GlobalCSEd/roversa/readme.md

## Roversa Robot!

This repository is not being updated/maintained any longer. please use [Roversa 2](https://github.com/eb8ga/roversa2) for the latest version.

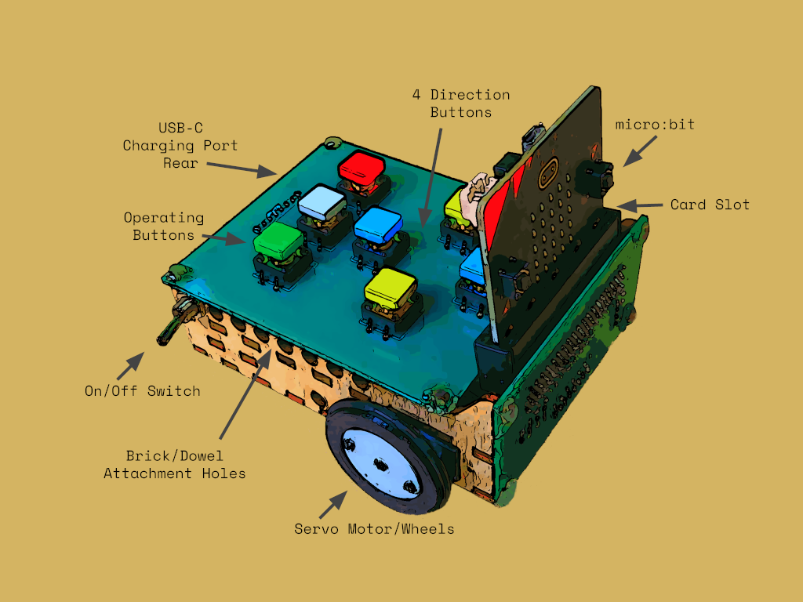
[picture p1: RAW_PICS/roversa v2.2-Getting Started GuideBCKGND.png]
roversa v2.1
