GlobalCSEd/roversa/CAD/PCB/readme.md

These are the two zip files containing gerber files for production. These can be dropped into a production site like OSHPark, JLC etc
