GlobalCSEd/roversa/RAW_PICS/IMG_20230713_214440.jpg

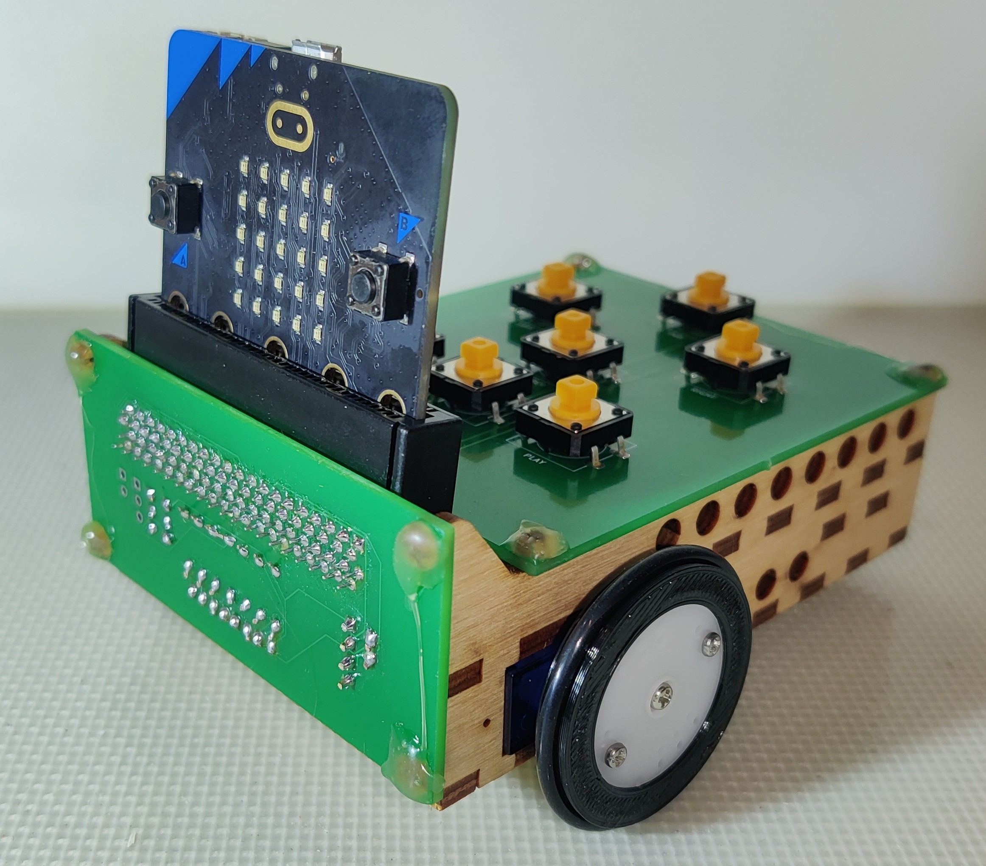
RAW_PICS/IMG_20230713_214440.jpg
