GlobalCSEd/roversa/RAW_PICS/IMG_20230713_214508.jpg

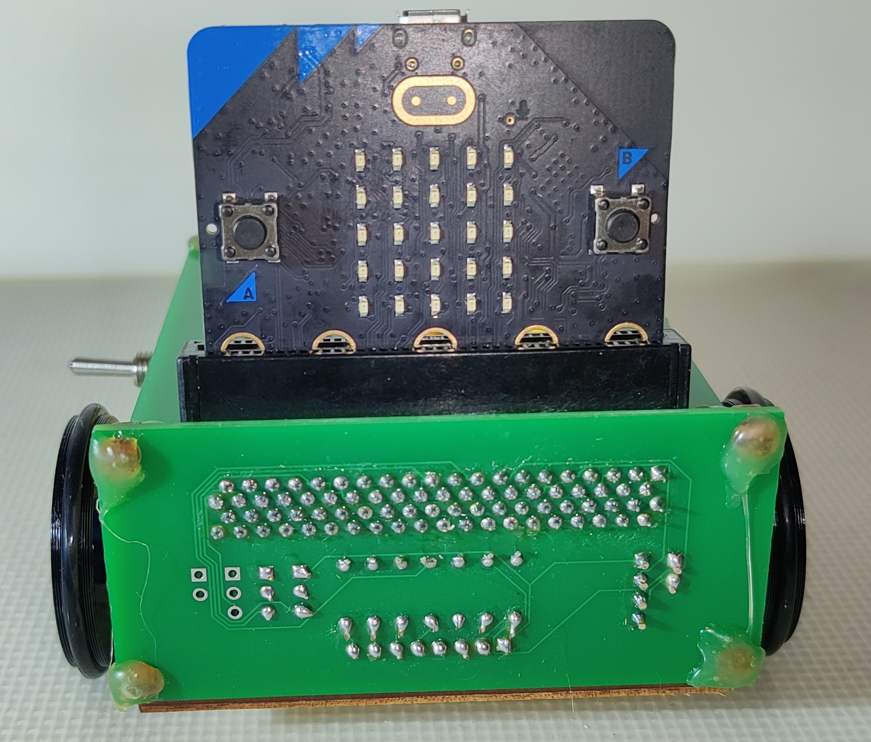
RAW_PICS/IMG_20230713_214508.jpg
