GlobalCSEd/roversa/RAW_PICS/IMG_20230713_214524.jpg

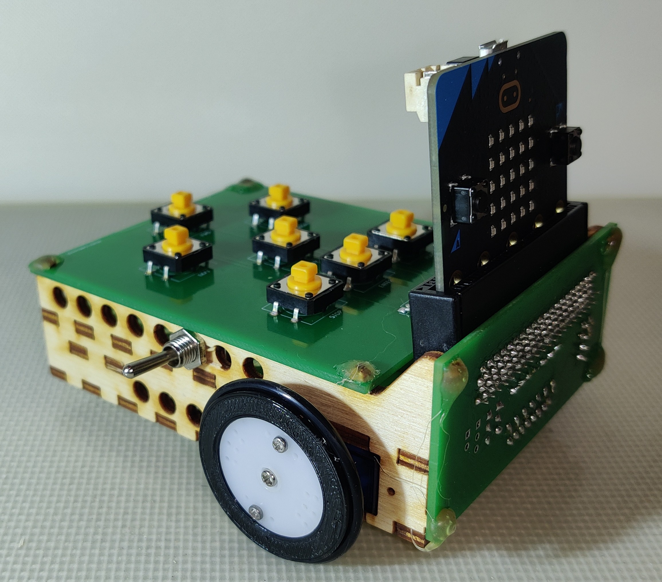
RAW_PICS/IMG_20230713_214524.jpg
