GlobalCSEd/roversa/RAW_PICS/IMG_20230713_214535.jpg

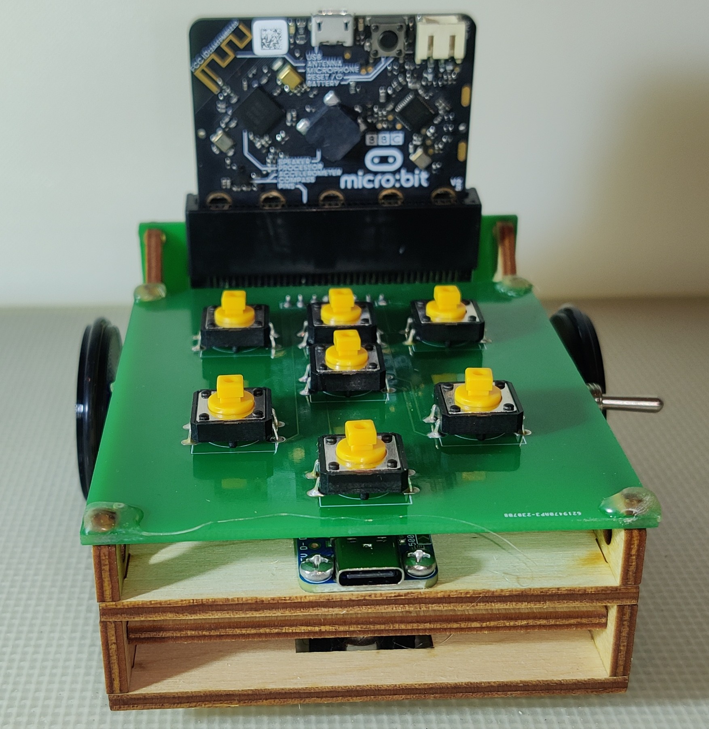
RAW_PICS/IMG_20230713_214535.jpg
