GlobalCSEd/roversa/RAW_PICS/IMG_20230713_214548.jpg

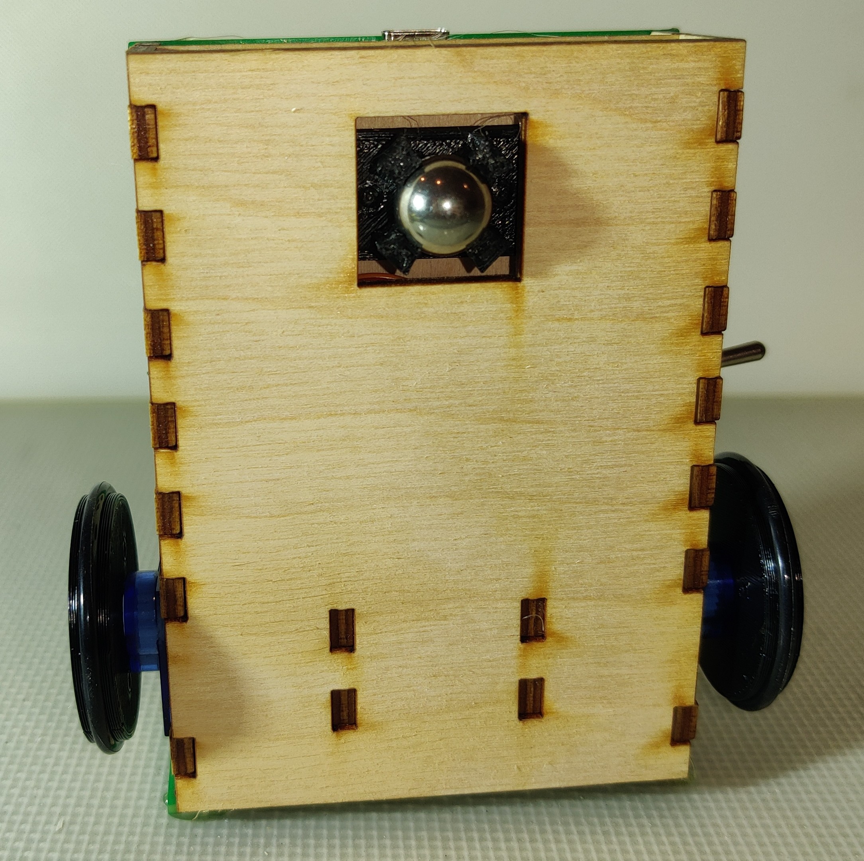
RAW_PICS/IMG_20230713_214548.jpg
