GlobalCSEd/roversa/RAW_PICS/IMG_20230713_214658.jpg

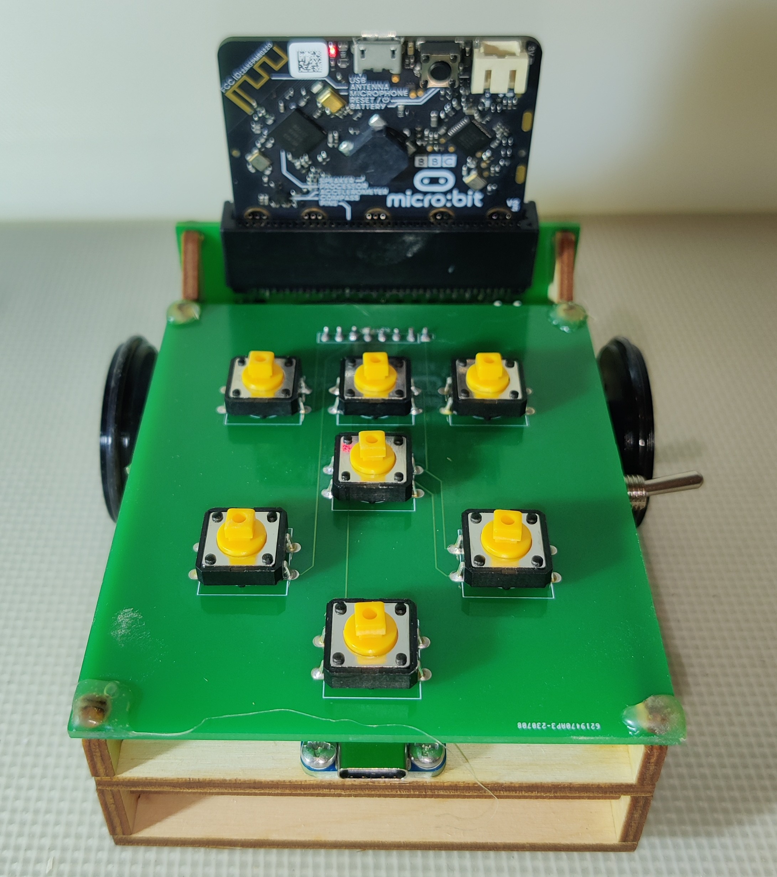
RAW_PICS/IMG_20230713_214658.jpg
