GlobalCSEd/roversa/RAW_PICS/IMG_20230713_214707.jpg

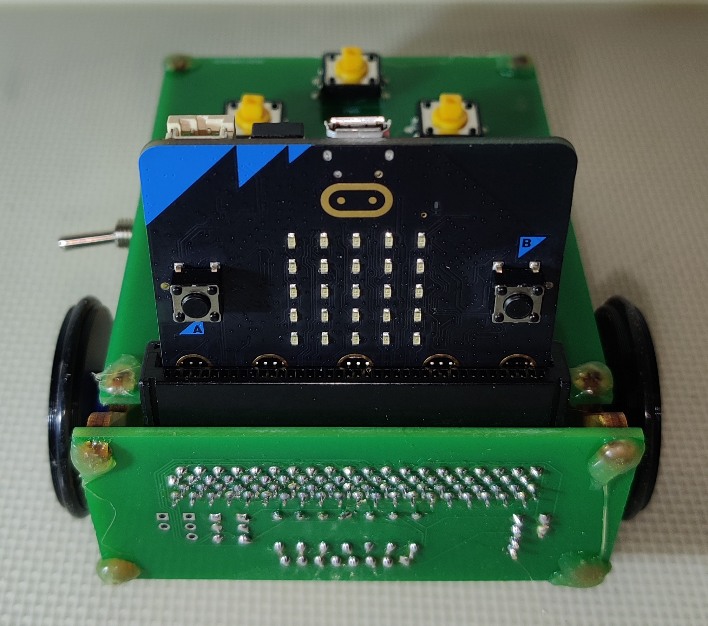
RAW_PICS/IMG_20230713_214707.jpg
