GlobalCSEd/roversa/RAW_PICS/IMG_20230713_214717.jpg

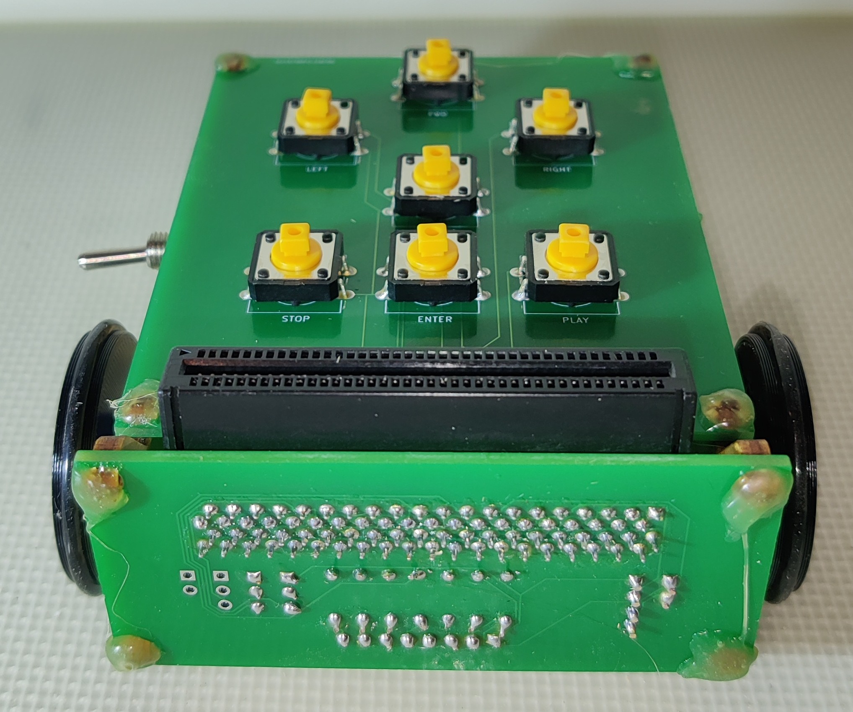
RAW_PICS/IMG_20230713_214717.jpg
