GlobalCSEd/roversa/RAW_PICS/IMG_20230713_214725.jpg

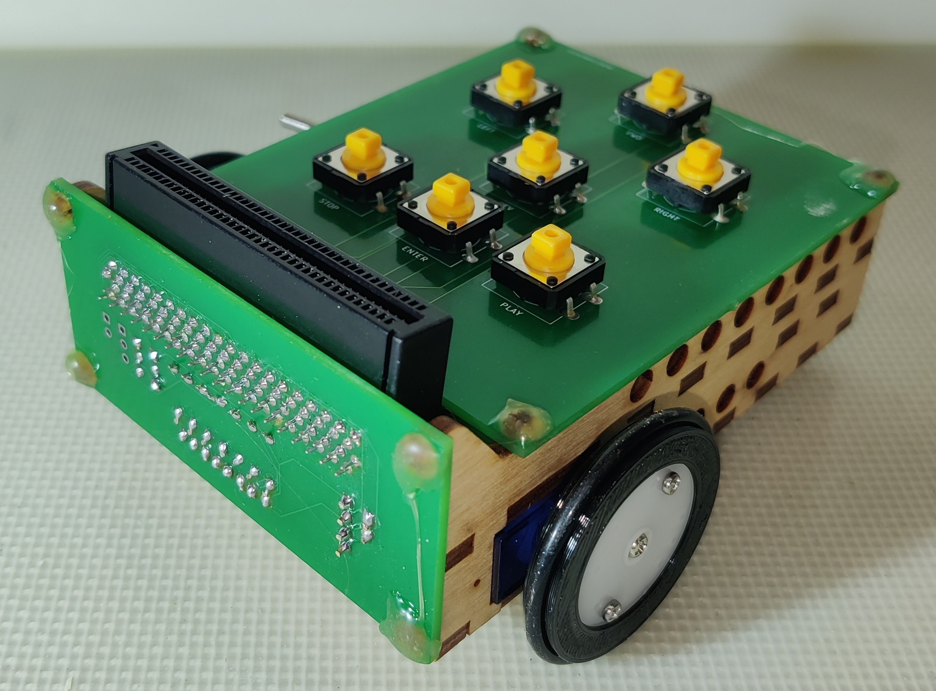
RAW_PICS/IMG_20230713_214725.jpg
