GlobalCSEd/roversa/RAW_PICS/IMG_20230713_214854.jpg

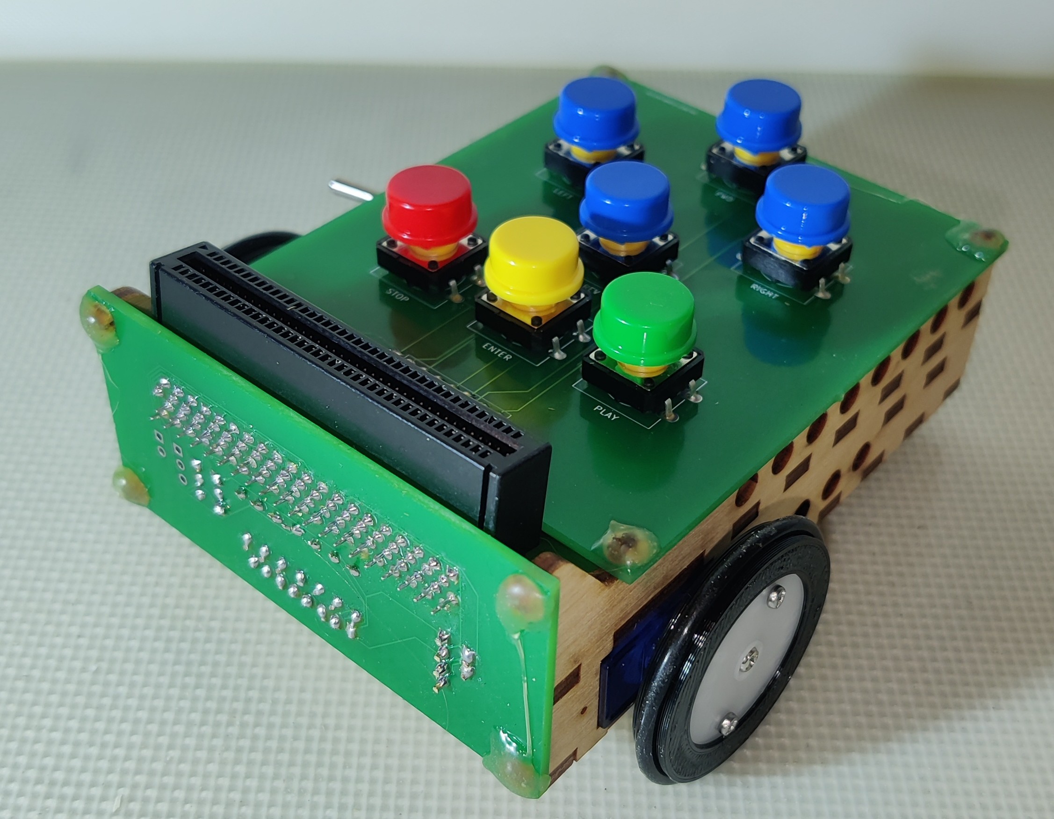
RAW_PICS/IMG_20230713_214854.jpg
