GlobalCSEd/roversa/RAW_PICS/IMG_20230713_214904.jpg

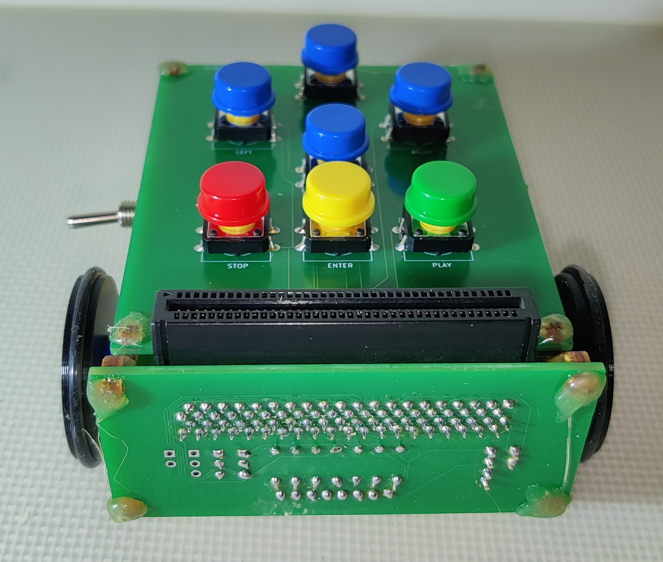
RAW_PICS/IMG_20230713_214904.jpg
