GlobalCSEd/roversa/RAW_PICS/IMG_20230713_214931.jpg

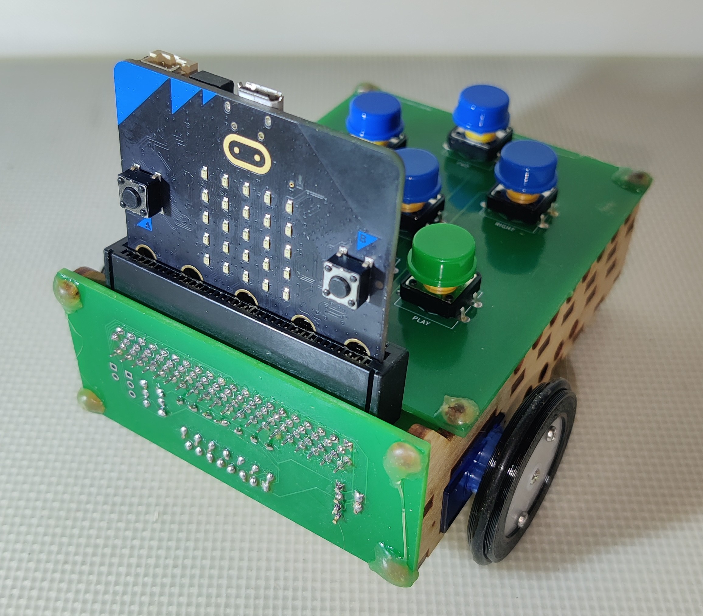
RAW_PICS/IMG_20230713_214931.jpg
