GlobalCSEd/roversa/RAW_PICS/IMG_20230713_214940.jpg

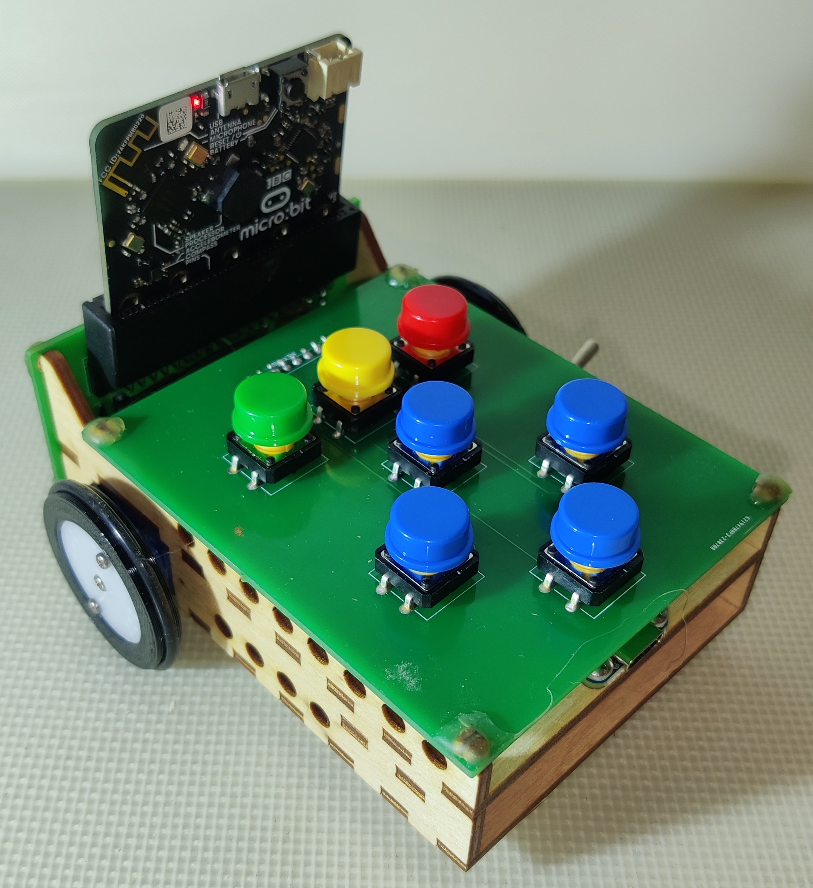
RAW_PICS/IMG_20230713_214940.jpg
