GlobalCSEd/roversa/RAW_PICS/IMG_20230713_215343.jpg

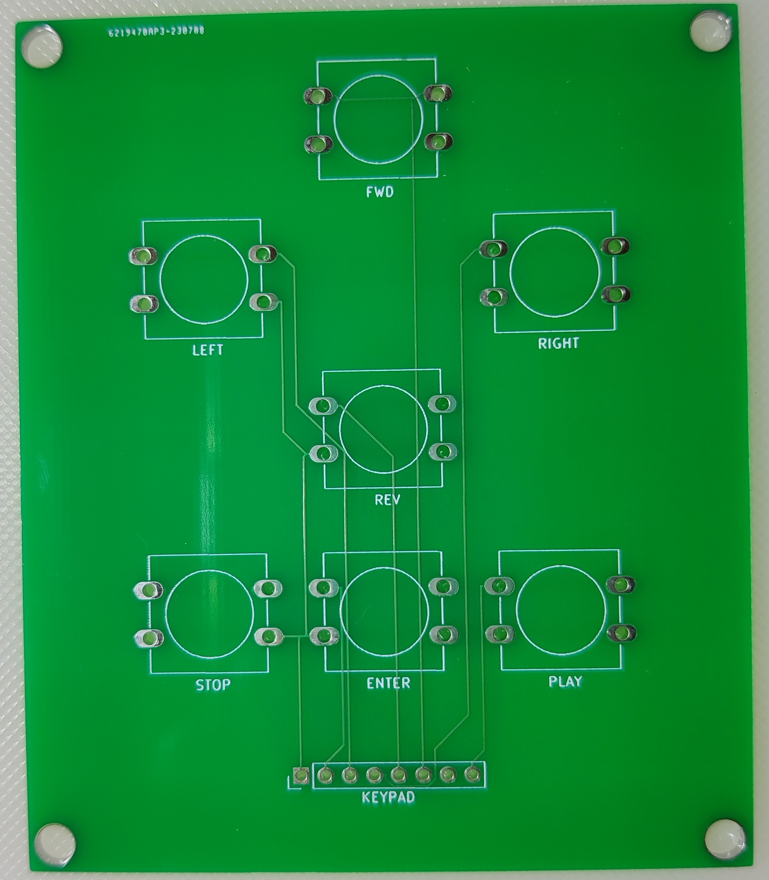
RAW_PICS/IMG_20230713_215343.jpg
