GlobalCSEd/roversa/RAW_PICS/IMG_20230713_215413.jpg

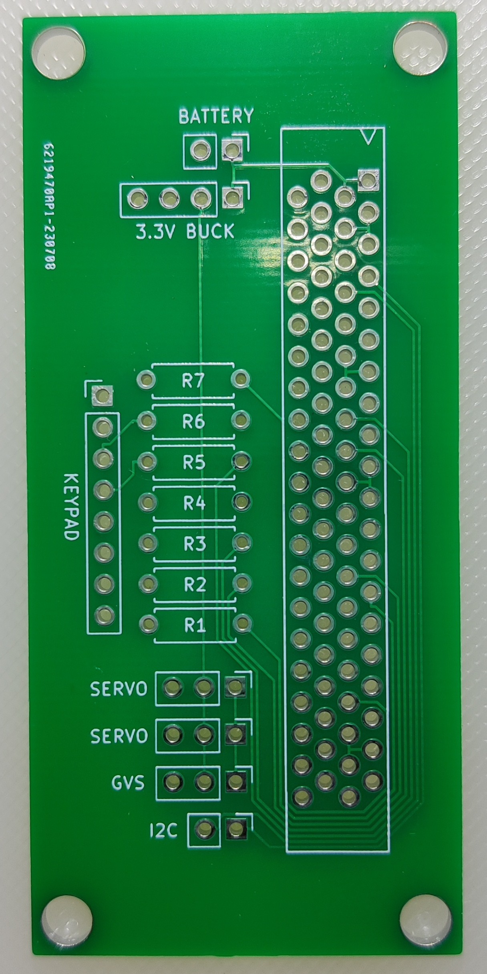
RAW_PICS/IMG_20230713_215413.jpg
