GlobalCSEd/roversa/RAW_PICS/IMG_20230808_182916__01.jpg

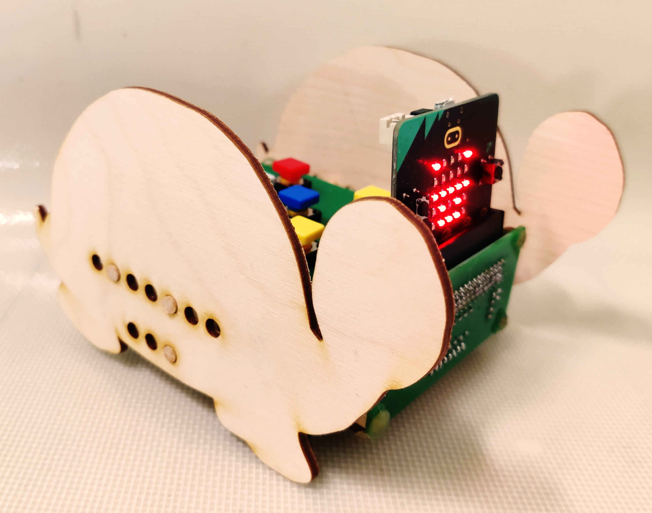
RAW_PICS/IMG_20230808_182916__01.jpg
