GlobalCSEd/roversa/BOM-mbRobotv2.2.xlsx

Sheet: START HERE
PLEASE READ BEFORE ORDERING PARTS
The sheet currentBuild has all the necessary parts to build Roversa. The sheet alternativeOptions has other sources and the parts we originally sourced to build v2.2 of the robot.
I will 3D print parts:
The Required parts list assumes you have capacity to 3D print the bearing holder and the wheels. If you have acces to a 3D printer, you can buy everything in the Required parts list and 3D print 1x Bearing Holder and 2x Wheels.
I will NOT 3D print parts:
If you do not have access to a 3D printer, you can buy everything on the Required parts list except the 12mm Ball Bearing, Nitrile Rubber O-Rings 35mm OD 30mm ID 2.5mm Width, and the M1.7x4mm Self-Tapping Screws. You will purchase 2x Wheel for Micro Continuous Rotation FS90R Servo, which comes with rubber tires. You can use the mounting screw from the servo horn kit provided. You will also purchase 1x 16mm Height Metal Caster Bearing Wheel, which comes with the steel ball bearing and holder. You may need to drill the mounting holes on this to fit the larger 2.5mm screws. They will then self-thread, so try to mount this once. Use a 2.05mm (5/64") drill bit for the pilot holes.
Production Notes
You will need to laser cut 1x chassis which is designed for 3mm playwood material (150 x 300 mm). They are sized to be able to fit 4x Roversa chassis layouts on one 300 x 600 mm sheet. All of the files are the same, we are just providing multiple formats to help work with different software.
You will need to manufacture 1x of each PCB zip files. They each contain all the gerber files necessary to create a full PCB to mount the micro:bit and also mount the button array.

Sheet: currentBuild
REQUIRED
Item | Component | Supplier Part No | Quantity | Cost (USD) | Total (USD) | Link | Notes | Datasheet
2x40 Right Angle Edge Connector for micro:bit | NA | 17252 | 1 | $2.95 | $2.95 | https://www.sparkfun.com/products/17252 | Use PTH version so it is easier to assemble | https://cdn-shop.adafruit.com/product-files/3342/Micro-Bit_connector_datasheet.pdf
Lithium Ion Polymer Battery - 3.7V 400mAh | NA | 13851 | 1 | $5.50 | $5.50 | https://www.sparkfun.com/products/13851 | Any LiPoly 3.7/4.2V Battery should work here - JST 2-Pin 25mm connector (check polarity) | https://cdn-shop.adafruit.com/product-files/3898/3898_specsheet_LP801735_400mAh_3.7V_20161129.pdf
Adafruit Micro-Lipo Charger for LiPoly Batt with USB Type C Jack | NA | 4410 | 1 | $5.95 | $5.95 | https://www.adafruit.com/product/4410 | Battery charge/maintenance, expensive can be integrated or cheaper version of LiPoly Charger | NA
2.2K ohm 5% 1/4W - Through-Hole Resistor | NA | 2782 | 7 | $0.03 | $0.21 | https://www.adafruit.com/product/2782 | Pull up resistors | https://adafruit.com/images/product-files/2780/Resistor_Data_Sheet.pdf
TLV62569 3.3V Buck Converter Breakout 3.3V Output 1.2A Max | NA | 4711 | 1 | $3.95 | $3.95 | https://www.adafruit.com/product/4711 | integrated circuit - fits to22 spot and has enable, not using currently | https://www.ti.com/lit/ds/symlink/tlv62569.pdf?ts=1696391638472
Continuous Rotation Micro Servo | FS90R | 114992423 | 2 | $2.90 | $5.80 | https://www.seeedstudio.com/Analog-Continuous-Steering-Servo-FS90R-p-4723.html | FSR90R - Variations may exist in mounting holes or size of part. CAD Matches the FITECH FS90R (https://www.adafruit.com/product/2442) | https://cdn-shop.adafruit.com/product-files/2442/FS90R-V2.0_specs.pdf
Colorful 12mm Square Tactile Button Switch | NA | NA | 7 | $0.13 | $0.91 | https://a.co/d/c8XVCTe | Any 12mm square tactile button will do, ones with caps are nice | https://cdn-shop.adafruit.com/datasheets/B3F-1000-Omron.pdf
Nitrile Rubber O-Rings 35mm OD 30mm ID 2.5mm Width | NA | NA | 2 | $0.22 | $0.44 | https://a.co/d/30GVs7j | O-rings for wheels - 3D printed wheel to attach to servo horn | NA
Latching Push Button Switch 3A 250V AC 2 Pins Self-Locking SPST ON/Off Black Mini Switch | NA | NA | 1 | $2.00 | $2.00 | https://a.co/d/6b5cvfP | Cleaner mounting option fits the v2.2 design | NA
M1.7x4mm Self-Tapping Screw | NA | NA | 4 | $0.01 | $0.04 | https://a.co/d/d1XQue5 | servo horn attachment - shorter so it doesn't polke through | NA
M2.5x6mm Pan Head Bolt/Screw | NA | NA | 6 | $0.09 | $0.54 | https://a.co/d/7hj75M6 | mount lipo charger and ball bearing holder if 3D printed | NA
12mm SS Ball Bearing | NA | NA | 1 | $0.50 | $0.50 | https://a.co/d/gPBLezj | Bearing is 12mm - 3D printed holder (if buying optional 16mm complete part- do not buy) | NA
 |  |  |  | TOTAL | $28.79 |  | Some of these are all really high prices and does not include microbit, wood, PCB
OPTIONAL
Item | Component | Supplier Part No | Quantity | Cost (USD) | Total (USD) | Link | Notes | Datasheet
16mm Height Metal Caster Bearing Wheel | NA | 3949 | 1 | $1.95 | $1.95 | https://www.adafruit.com/product/3949 | comes with ball bearing and holder (no need to 3D print anything, do not buy the 12mm ball bearing) | NA
Wheel for Micro Continuous Rotation FS90R Servo | NA | 2744 | 2 | $2.50 | $2.50 | https://www.adafruit.com/product/2744 | Different diameter than 3D printed wheels (no need to 3D print or use the M1.7x4mm screws) | https://www.adafruit.com/images/product-files/2744/2744%20data.pdf
microbit v2 | NA | 17287 | 1 | $16.50 | $16.50 | https://www.sparkfun.com/products/17287 | microbit v2 - assuming have this in base price | http://tech.microbit.org/
 |  |  |  | ADDITIONAL | $20.95 |  | extra items
 |  |  |  | TOTAL | $48.76 |  | base plus extra items, minus the servo horn screws, O-rings, and the ball bearing
PRODUCTION
Part | Material | Process | Files
Chassis | 3mm plywood | laser cut | SVG (https://github.com/GlobalCSEd/roversa/raw/main/CAD/mbRobotv2.2-8.8.23.svg) | PDF (https://github.com/GlobalCSEd/roversa/raw/main/CAD/mbRobotv2.2-8.8.23.pdf) | AI (https://github.com/GlobalCSEd/roversa/raw/main/CAD/mbRobotv2.2-8.8.23.ai)
Wheels | PETG | 3D printed | AMF (https://github.com/GlobalCSEd/roversa/raw/main/CAD/3DPrint/oRingServoWheel_30mmID.amf) | STL (https://github.com/GlobalCSEd/roversa/raw/main/CAD/3DPrint/oRingServoWheel_30mmID.stl)
Bearing Holder | PETG | 3D printed | AMF (https://github.com/GlobalCSEd/roversa/raw/main/CAD/3DPrint/bearingHolder-v2.2.amf) | STL (https://github.com/GlobalCSEd/roversa/raw/main/CAD/3DPrint/bearingHolder-v2.2.stl)
PCB - micro:bit | FR1 | PCB | ZIP (Gerbers) (https://github.com/GlobalCSEd/roversa/raw/main/CAD/PCB/gerbers-PCB-front_uBit.zip)
PCB - buttons | FR1 | PCB | ZIP (Gerbers) (https://github.com/GlobalCSEd/roversa/raw/main/CAD/PCB/gerbers-PCB-top_buttons.zip)

Sheet: alternativeOptions
Optional sources for cheaper options: | Supplier # | Cost/unit | Link
micro:bit edge connector | 17252 | $2.95 | https://www.sparkfun.com/products/17252
FS90R Servo Continuous Servo Motor |  | $5.95 | https://www.pololu.com/product/2820
FS90R Servo Continuous Servo Motor |  | $2.90 | https://www.seeedstudio.com/Analog-Continuous-Steering-Servo-FS90R-p-4723.html
400mah Lipo batteries |  | $4.00 | https://a.co/d/1dGfb0P
MPU6050 Gyro |  | $3.33 | https://a.co/d/0D5Rwem
12mm tactile buttons |  | $0.13 | https://a.co/d/c8XVCTe
SPST Momentary Latching |  | $2.00 | https://a.co/d/6b5cvfP
Lithium Ion Polymer Battery - 3.7V 400mAh | 13851 | $5.50 | https://www.sparkfun.com/products/13851
Original Parts (CAD-model): | Supplier # | Cost/unit | Link
FS90R Continuous Servo Motor | 2442 | $7.50 | https://www.adafruit.com/product/2442
micro:bit edge connector | 3342 | $5.95 | https://www.adafruit.com/product/3342
12mm tactile buttons | 1010 | $0.40 | https://www.adafruit.com/product/1010
SPST Momentary Latching |  | $3.25 | https://a.co/d/gLQk6vy
Lithium Ion Polymer Battery - 3.7V 400mAh | 3898 | $6.95 | https://www.adafruit.com/product/3898
