GlobalCSEd/roversa/CAD/3DPrint/CAD-v2.1/bearingHolder-v2.1.stl

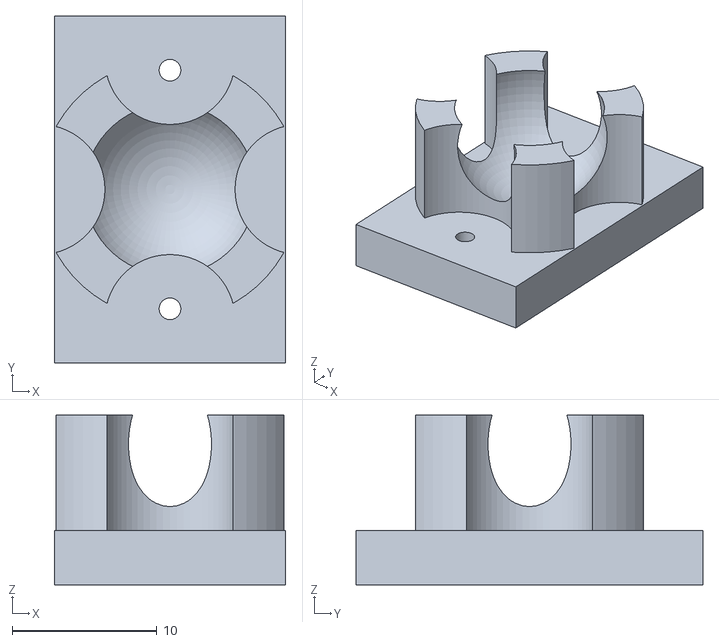
[picture p19: CAD file, 2023-09-07]
CAD/3DPrint/CAD-v2.1/bearingHolder-v2.1.stl
16.0 x 24.0 x 11.8
