GlobalCSEd/roversa/CAD/3DPrint/oRingServoWheel_30mmID.stl

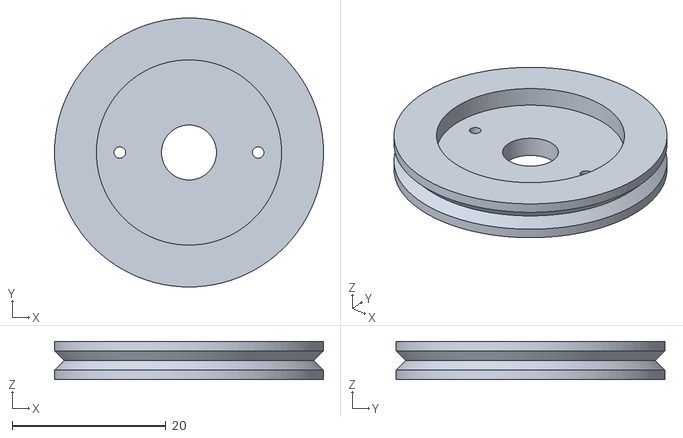
[picture p20: CAD file, 2023-09-07]
CAD/3DPrint/oRingServoWheel_30mmID.stl
35.0 x 35.0 x 5.00
