GlobalCSEd/roversa/(list of files, cad)

Other CAD files:
CAD/3DPrint/bearingHolder-v2.2.stl
CAD/3DPrint/CAD-v2.1/bearingHolder-v2.1.amf
CAD/3DPrint/bearingHolder-v2.2.amf
CAD/3DPrint/oRingServoWheel_30mmID.amf
