GlobalCSEd/roversa/ASSEMBLY/cadExploded.gif

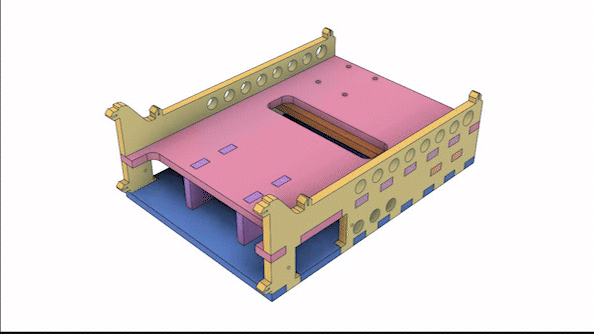
ASSEMBLY/cadExploded.gif
