GlobalCSEd/roversa/CAD/PCB/schematic_rev2.1.pdf

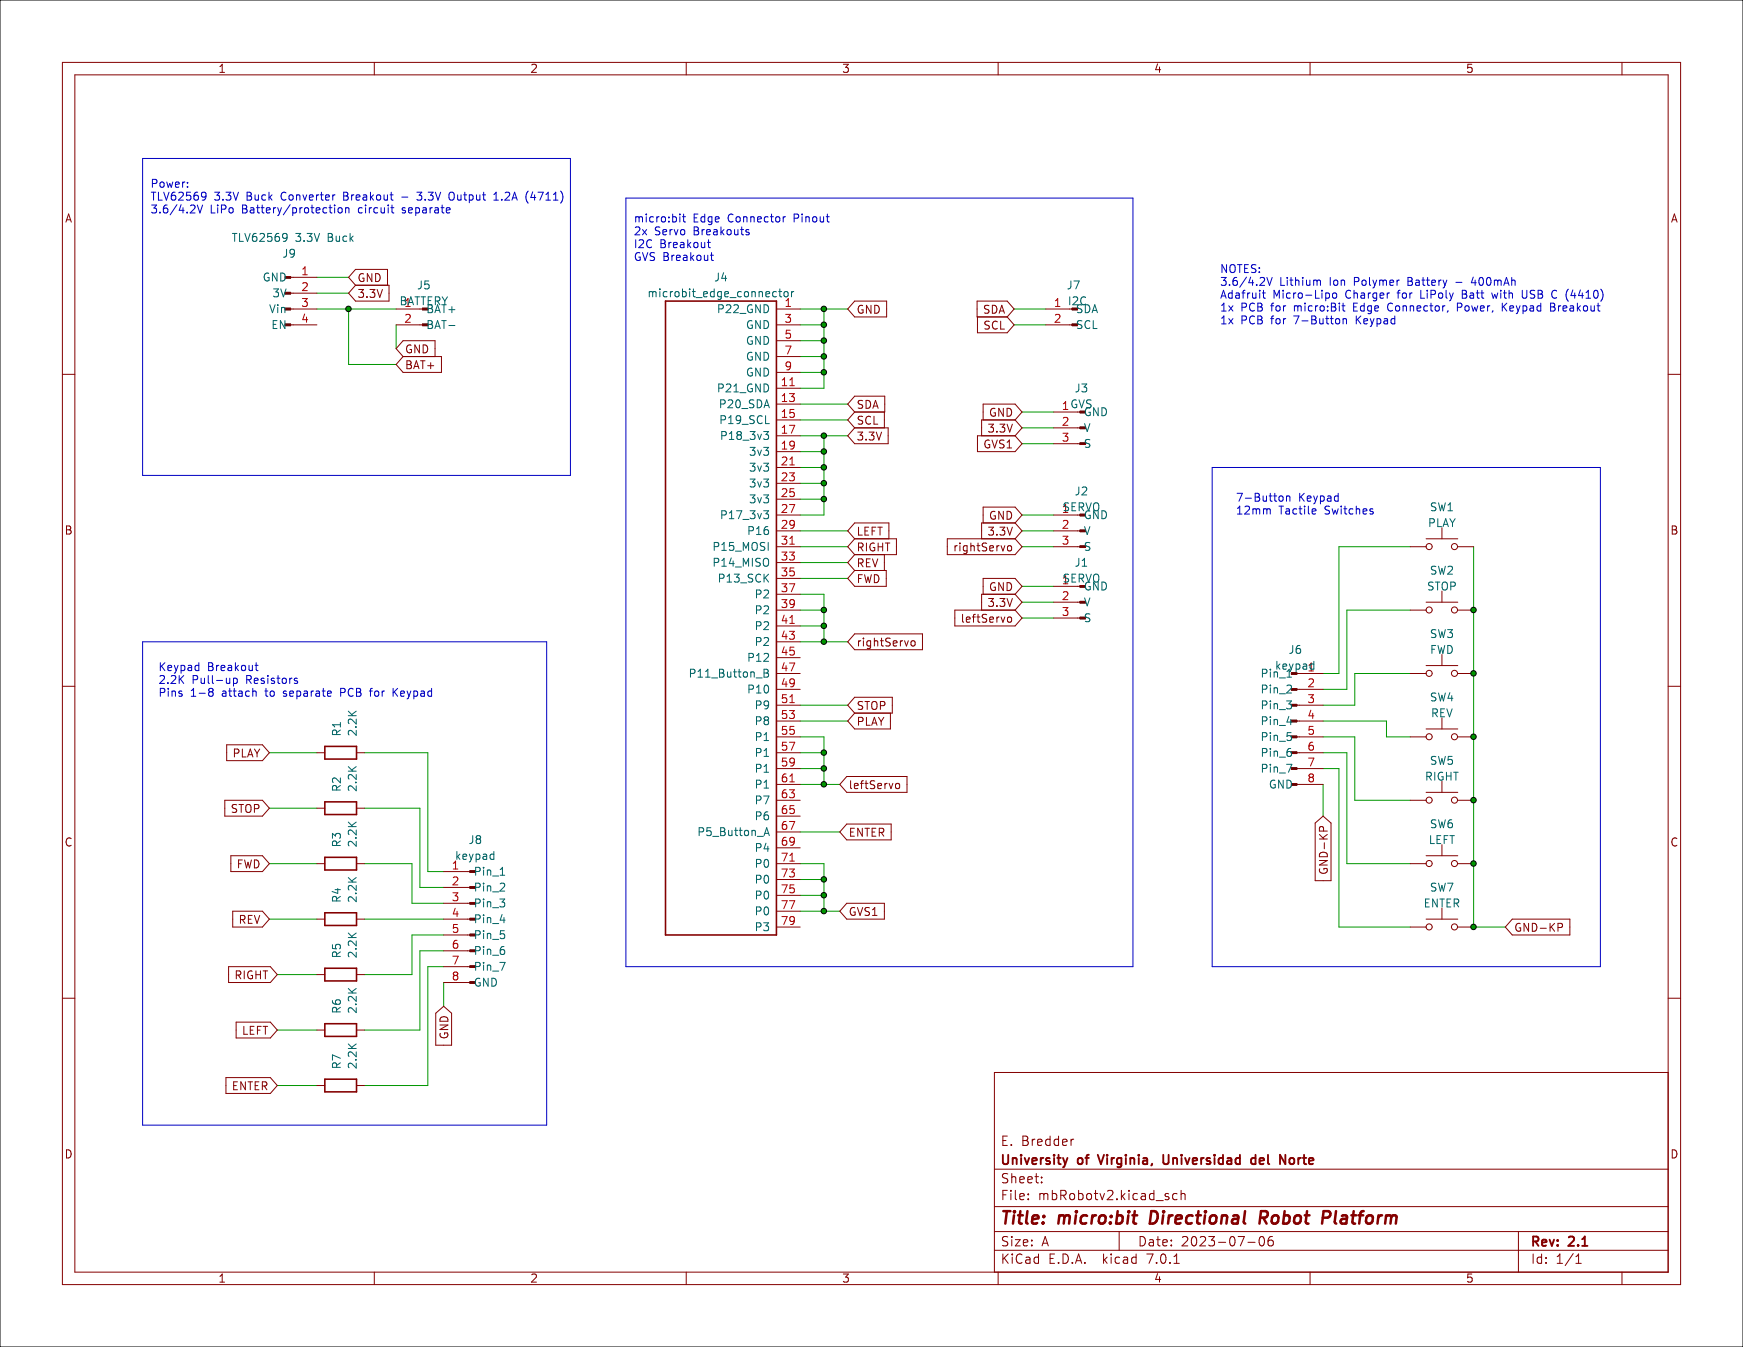
[picture p22: page 1]
