GlobalCSEd/roversa/COSTUMES/Custume Cat Disfraz Gato.pdf

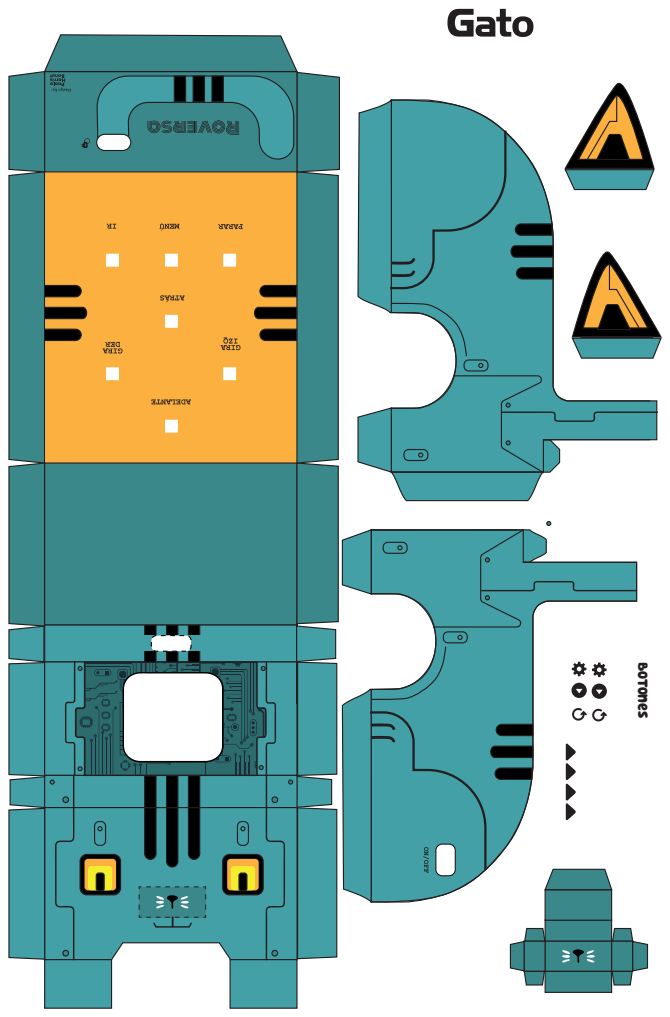
[picture p23: page 1]
Botones
