GlobalCSEd/roversa/COSTUMES/Custume Fox Disfraz Fox.pdf

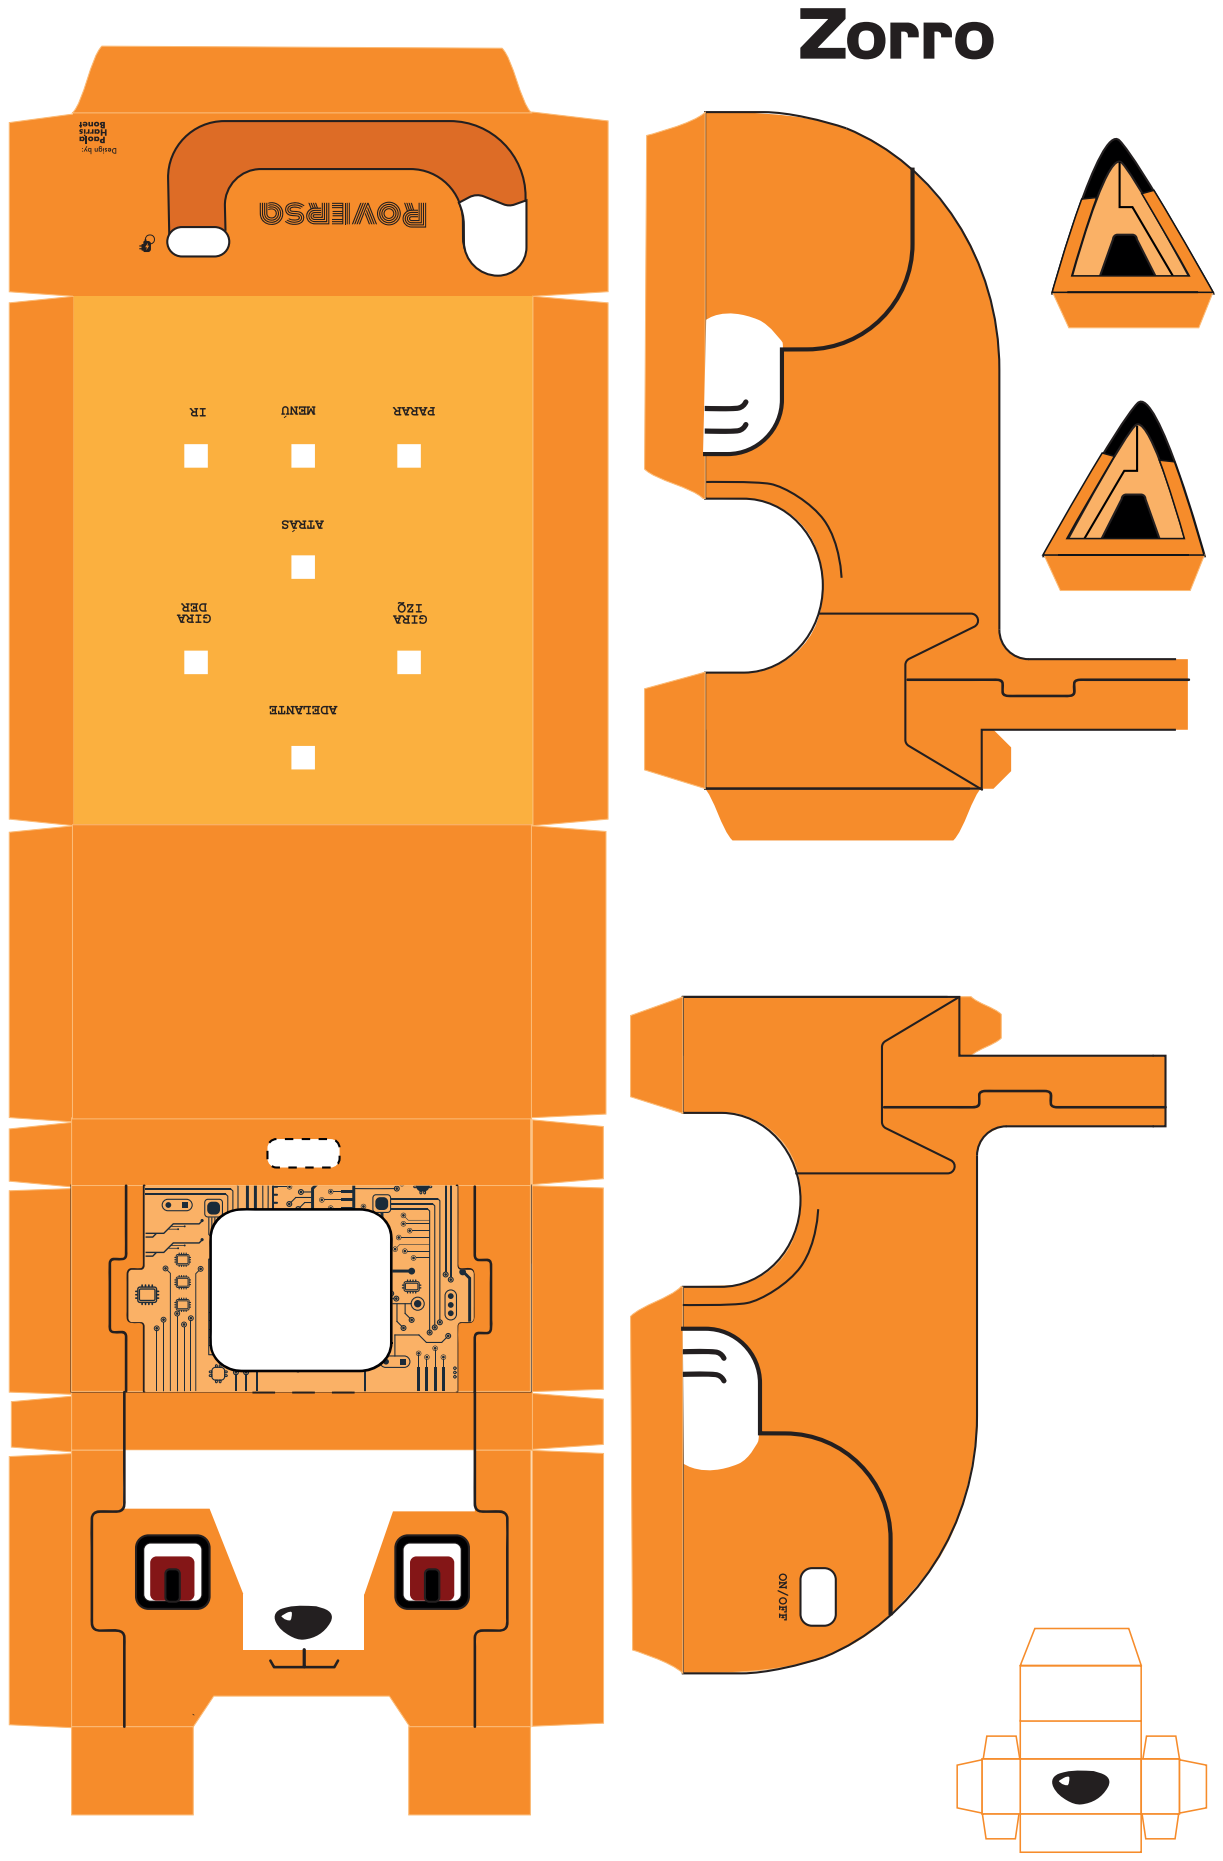
[picture p24: page 1]
