GlobalCSEd/roversa/COSTUMES/Custume Iguana Disfraz Iguana.pdf

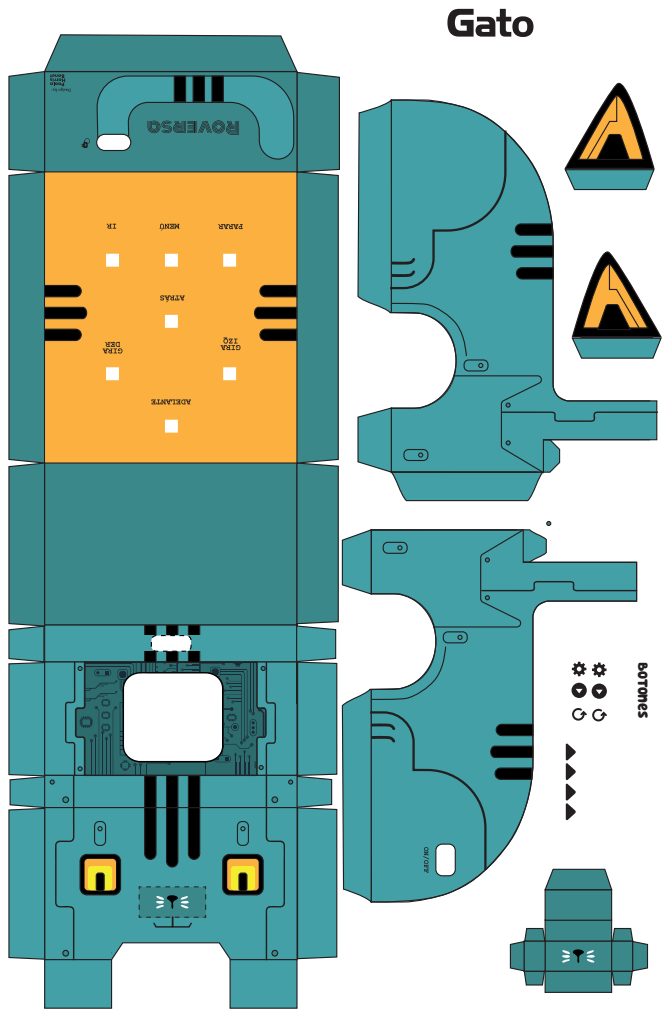
[picture p25: page 1]
Botones

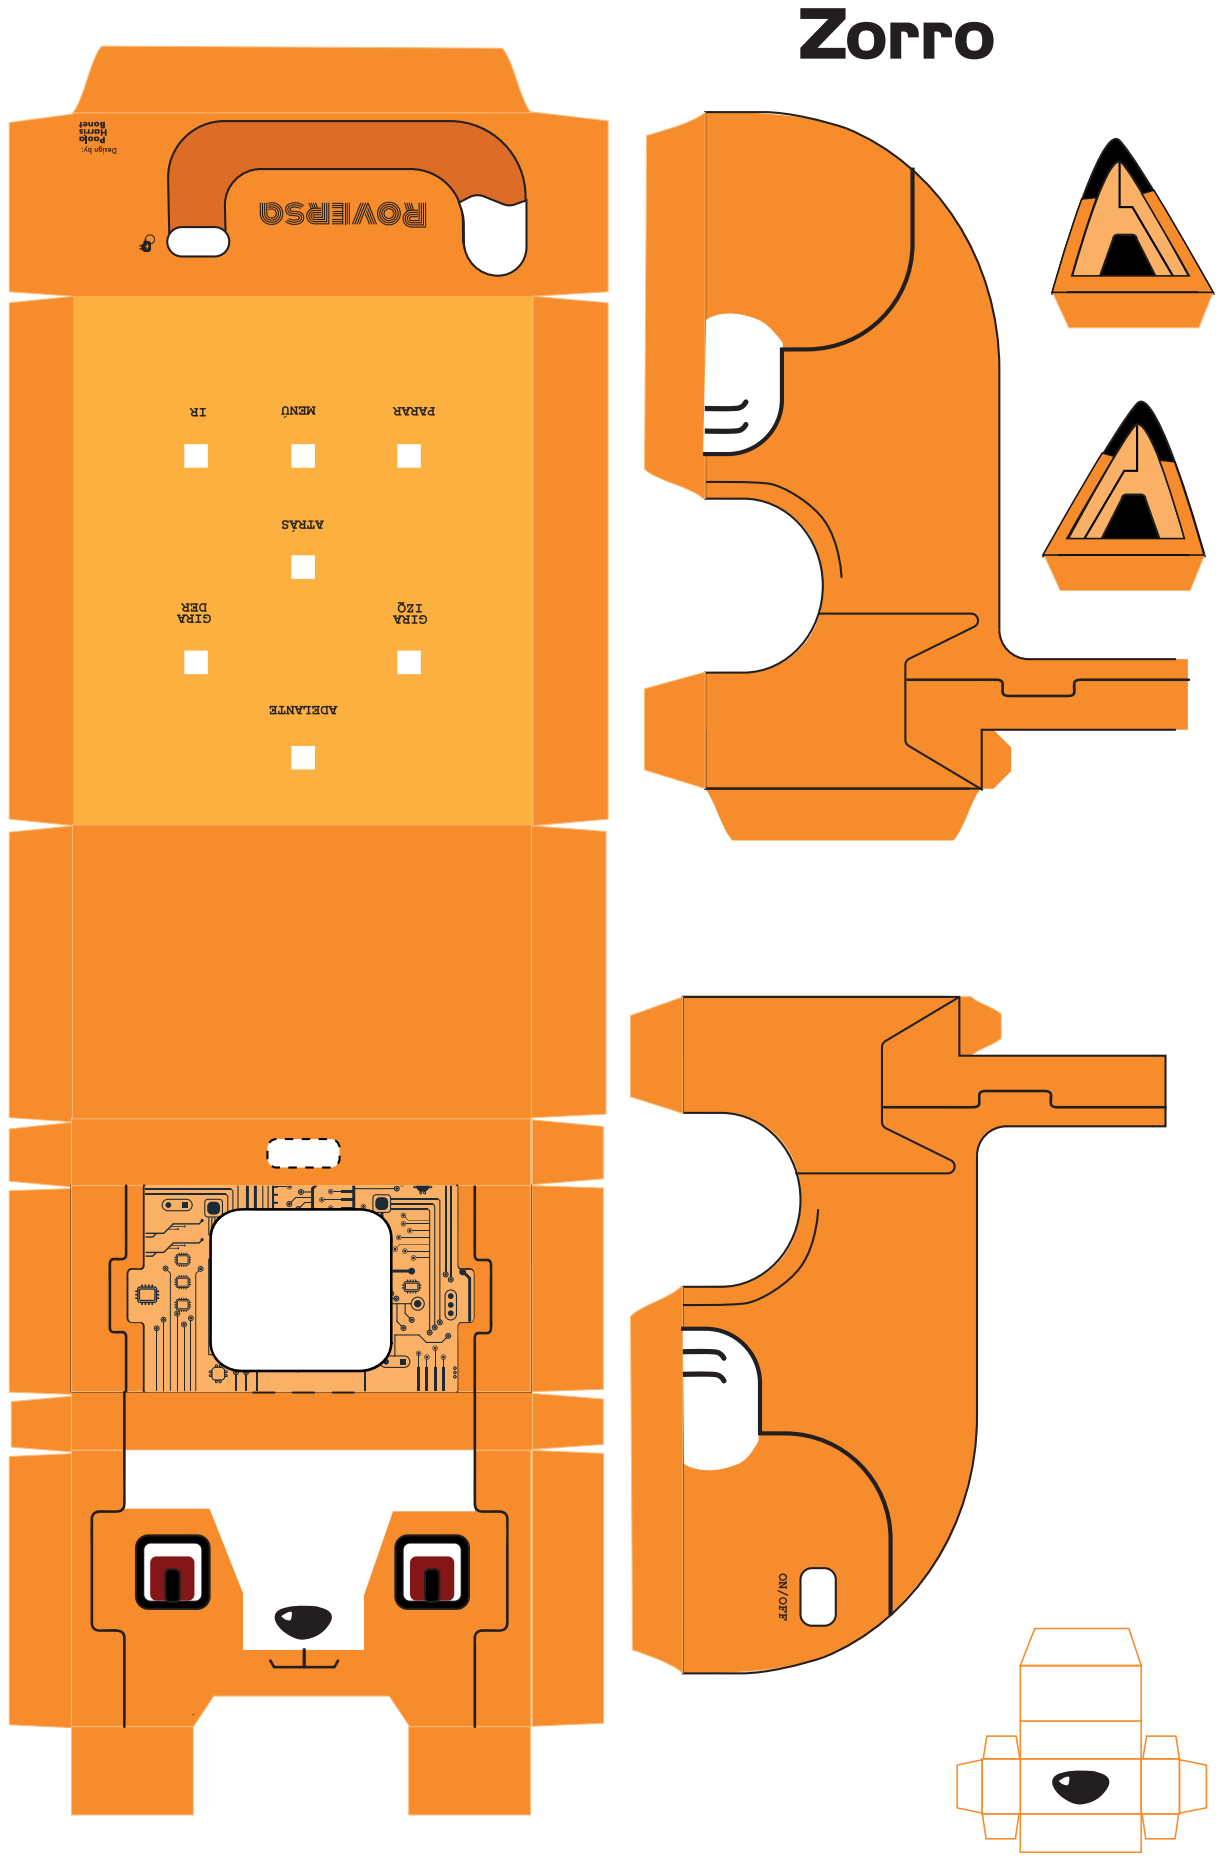
[picture p26: page 2]

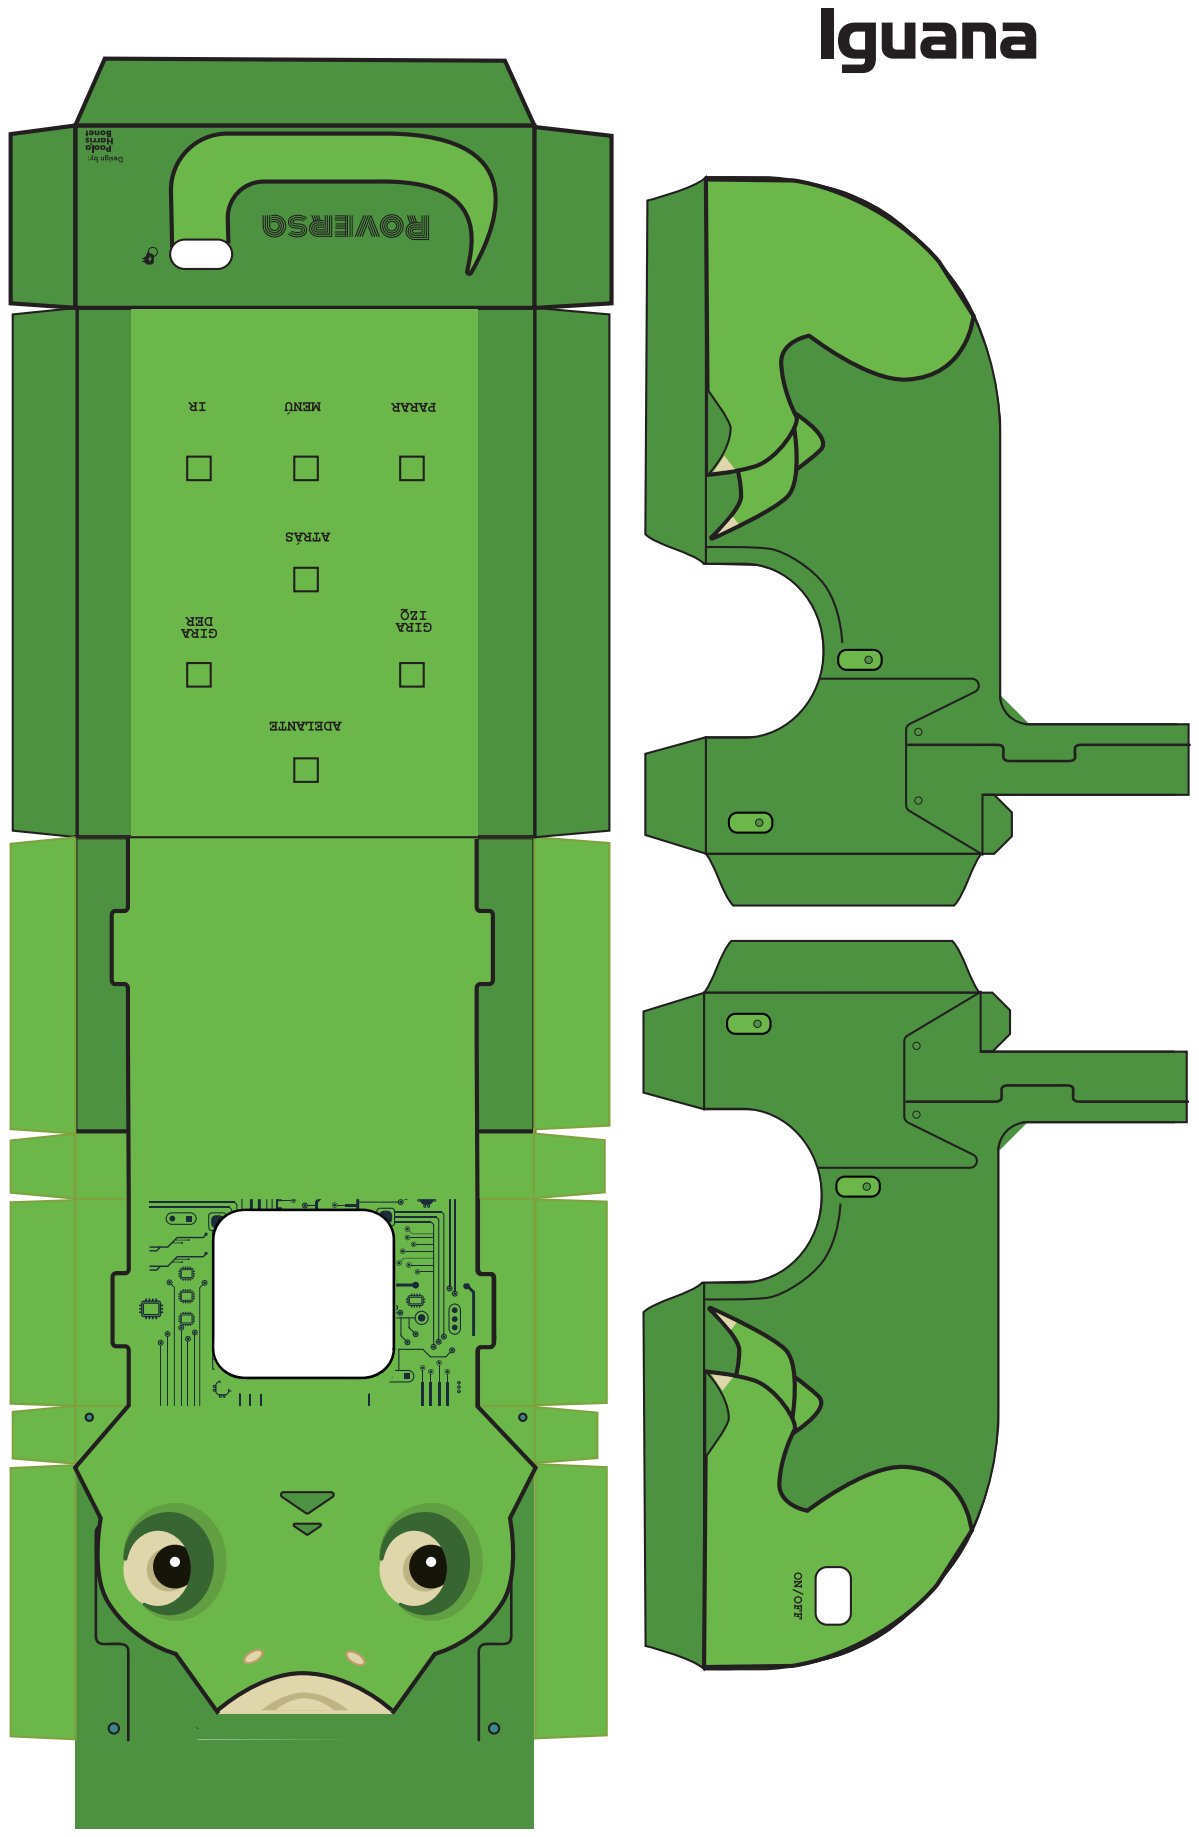
[picture p27: page 3]
