GlobalCSEd/roversa/CAD/mbRobotv2.2-8.8.23.pdf

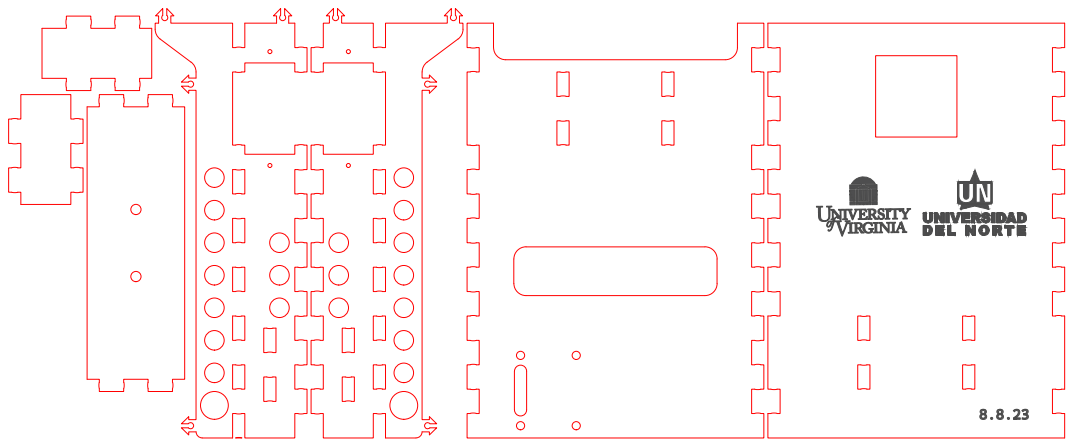
[picture p28: page 1]
