GlobalCSEd/roversa/CAD/mbRobotv2.2-turtleCostume.pdf

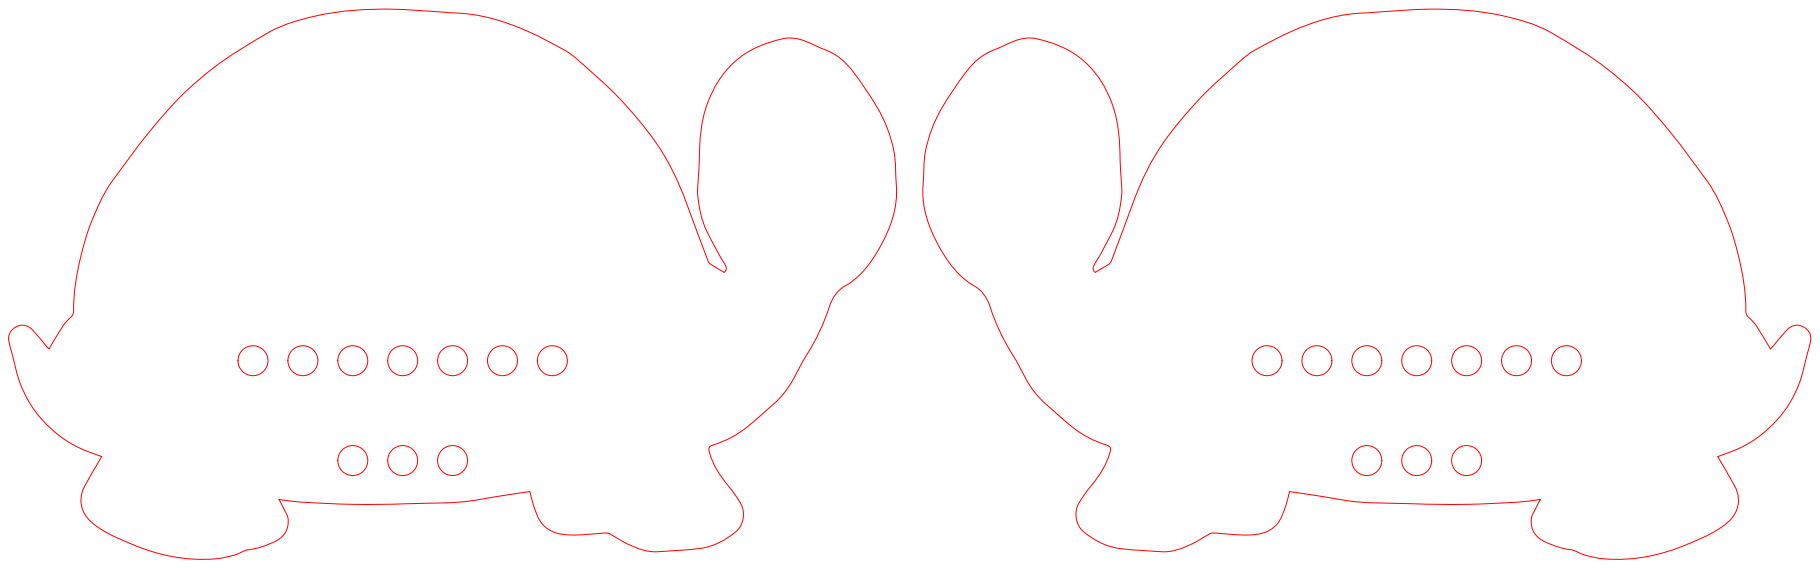
[picture p29: page 1]
