GlobalCSEd/roversa/CAD/v2.1-laserCut/mbRobotFinal-2.1-7.19.23.pdf

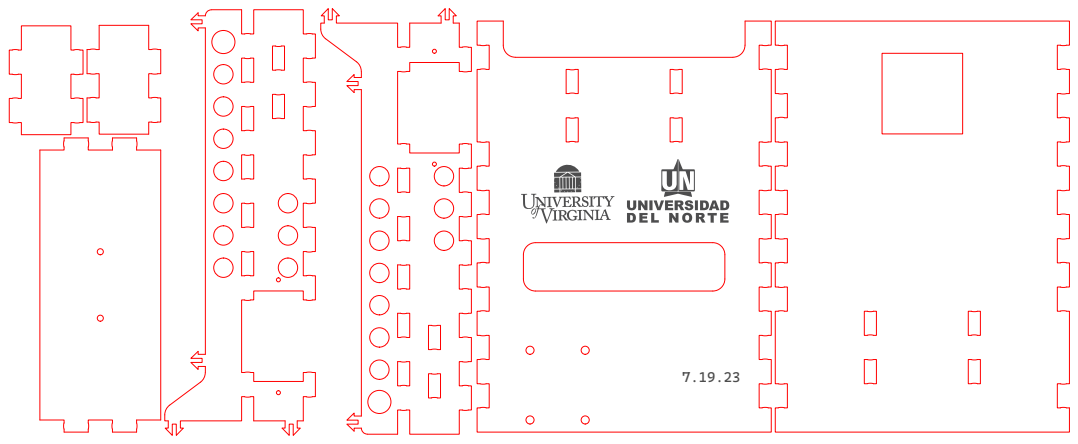
[picture p30: page 1]
