GlobalCSEd/roversa/(commit log)

2023-09-07 Add files via upload
    initial upload from g drive
    [BOM-mbRobotv2.1.xlsx, bearingHolder-v2.1.amf, bearingHolder-v2.1.stl, bearingHolder-v2.2.amf, bearingHolder-v2.2.stl, oRingServoWheel_30mmID.amf, oRingServoWheel_30mmID.stl]
2023-10-04 Create Gerbers
